Nicolas-Martinez-C/proto-synth-v2/docs/Pinout ProtoSynth V2.pdf

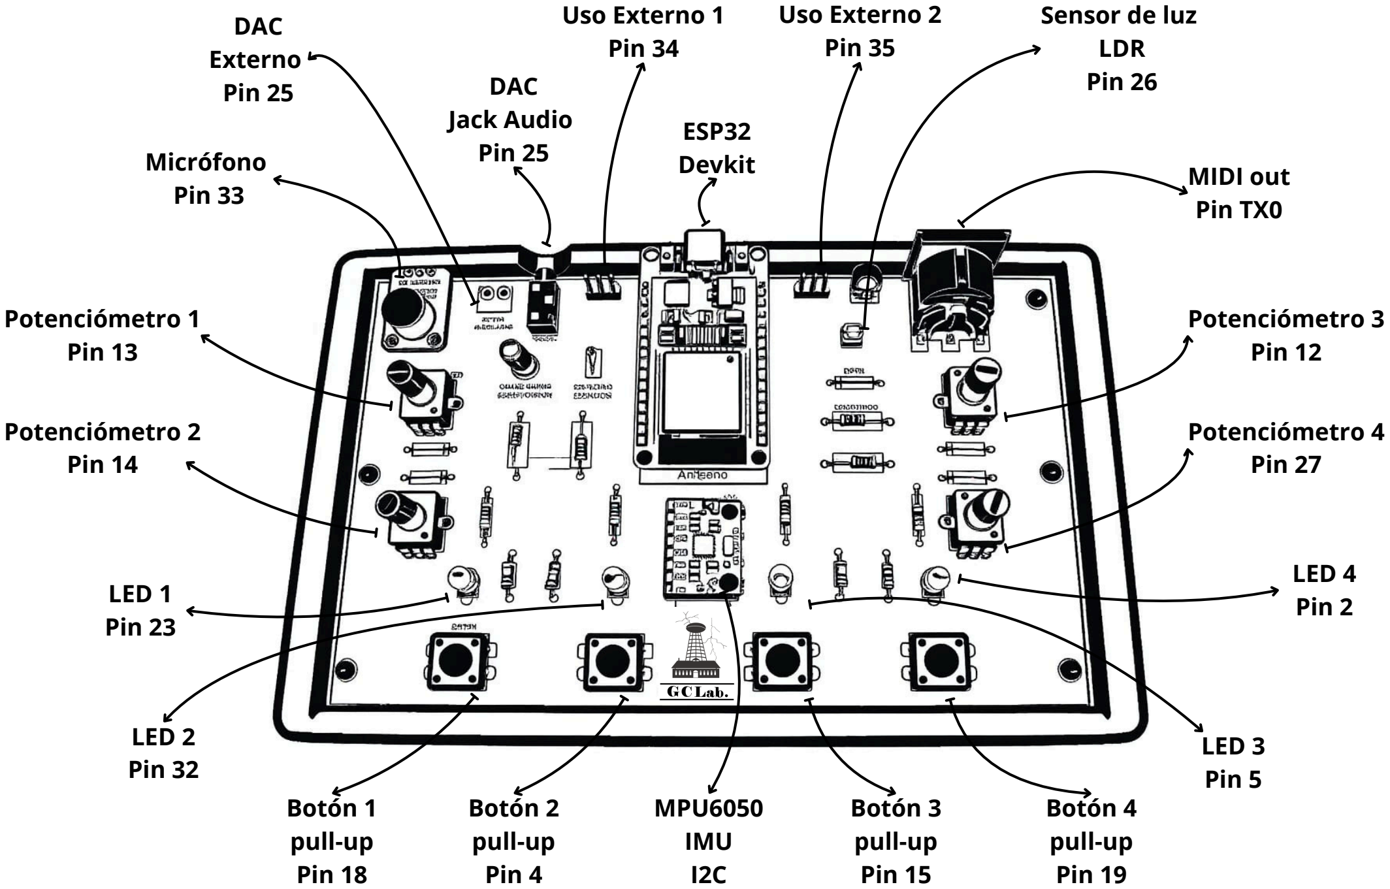
[picture p2: page 1]

Micrófono
Pin 33

Potenciómetro 1
Pin 13

Potenciómetro 2
Pin 14

DAC
Jack Audio
Pin 25

Potenciómetro 3
Pin 12

Potenciómetro 4
Pin 27

Botón 4
pull-up
Pin 19

Botón 3
pull-up
Pin 15

Botón 2
pull-up
Pin 4

Botón 1
pull-up
Pin 18

MIDI out
Pin TX0

ESP32
Devkit

Uso Externo 2
Pin 35

Uso Externo 1
Pin 34

DAC
Externo
Pin 25

Sensor de luz
LDR
Pin 26

LED 1
Pin 23

LED 2
Pin 32

LED 3
Pin 5

LED 4
Pin 2

MPU6050
IMU
I2C

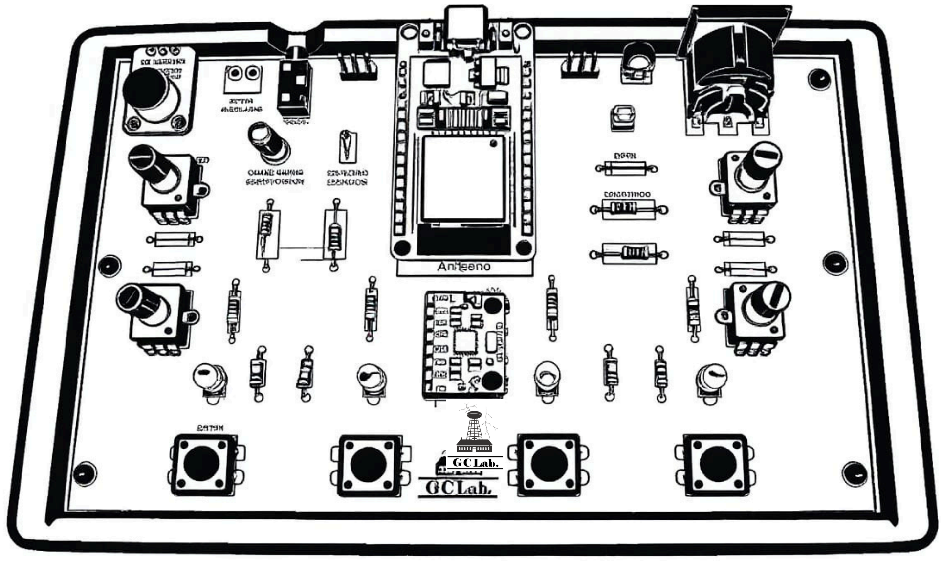
[picture p3: page 2]
