Nicolas-Martinez-C/proto-synth-v2/images/Conector de audifonos.png

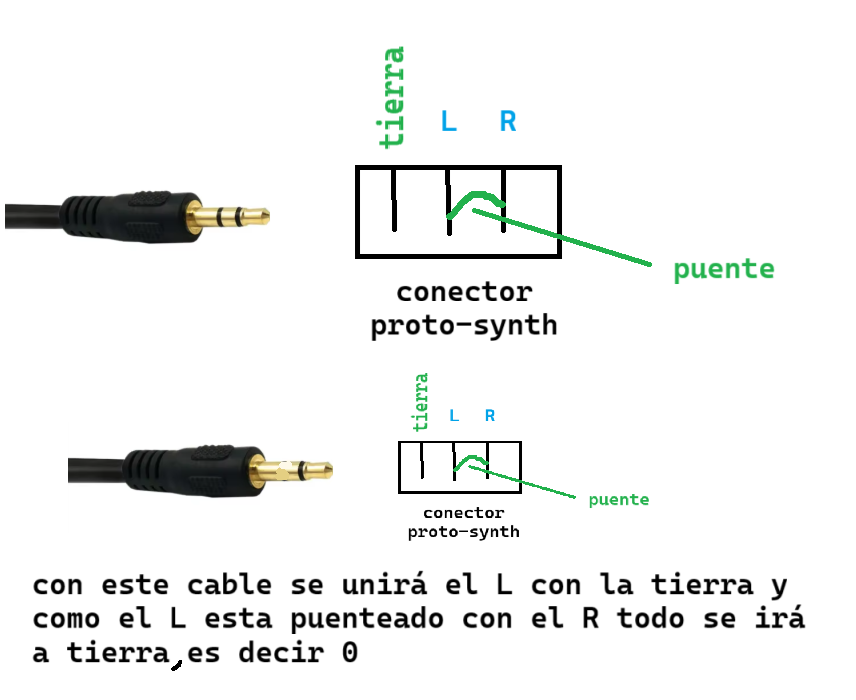
images/Conector de audifonos.png
