Nicolas-Martinez-C/proto-synth-v2/images/kit-Proto-synth.jpeg

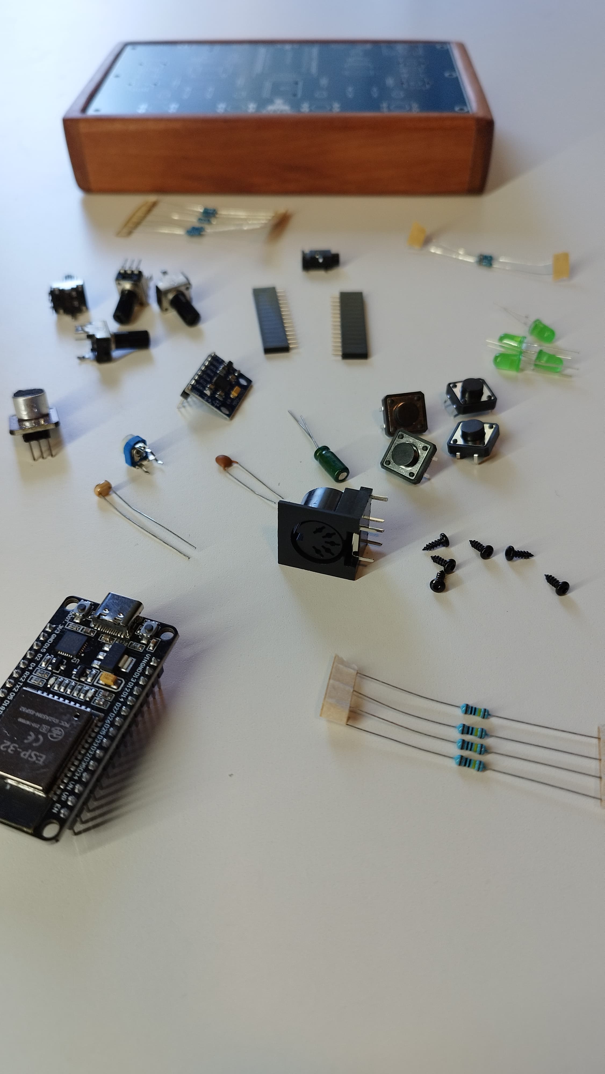
images/kit-Proto-synth.jpeg
