Nicolas-Martinez-C/proto-synth-v2/images/Proto-Synth-v1 y 2.jpeg

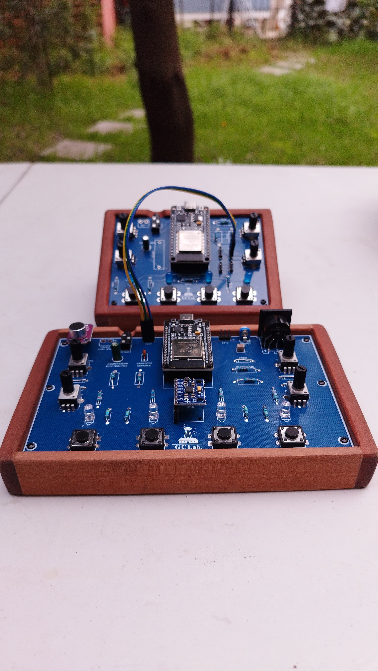
images/Proto-Synth-v1 y 2.jpeg
