Nicolas-Martinez-C/proto-synth-v2/images/Proto-synth-v2.0.0.jpeg

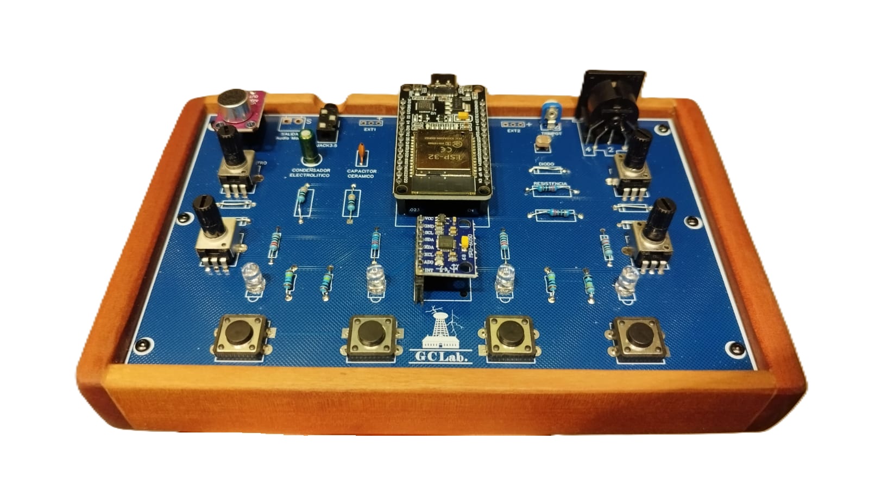
images/Proto-synth-v2.0.0.jpeg
