Nicolas-Martinez-C/proto-synth-v2/images/proto-synth-v2.jpg

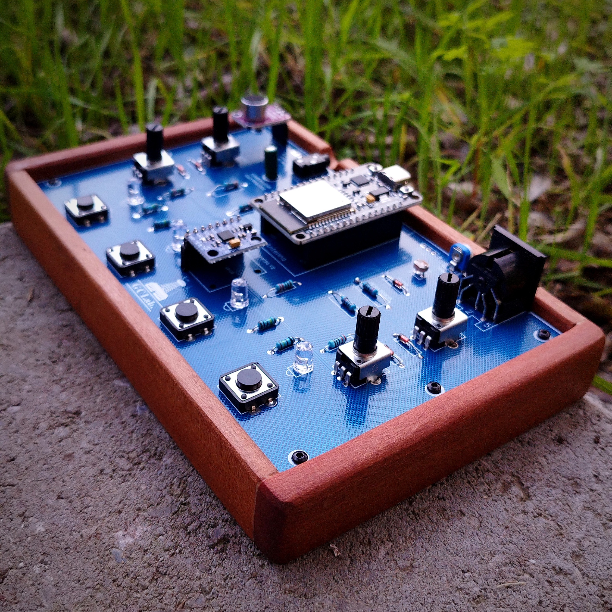
images/proto-synth-v2.jpg
