Nicolas-Martinez-C/proto-synth-v2/images/Proto_synth.png

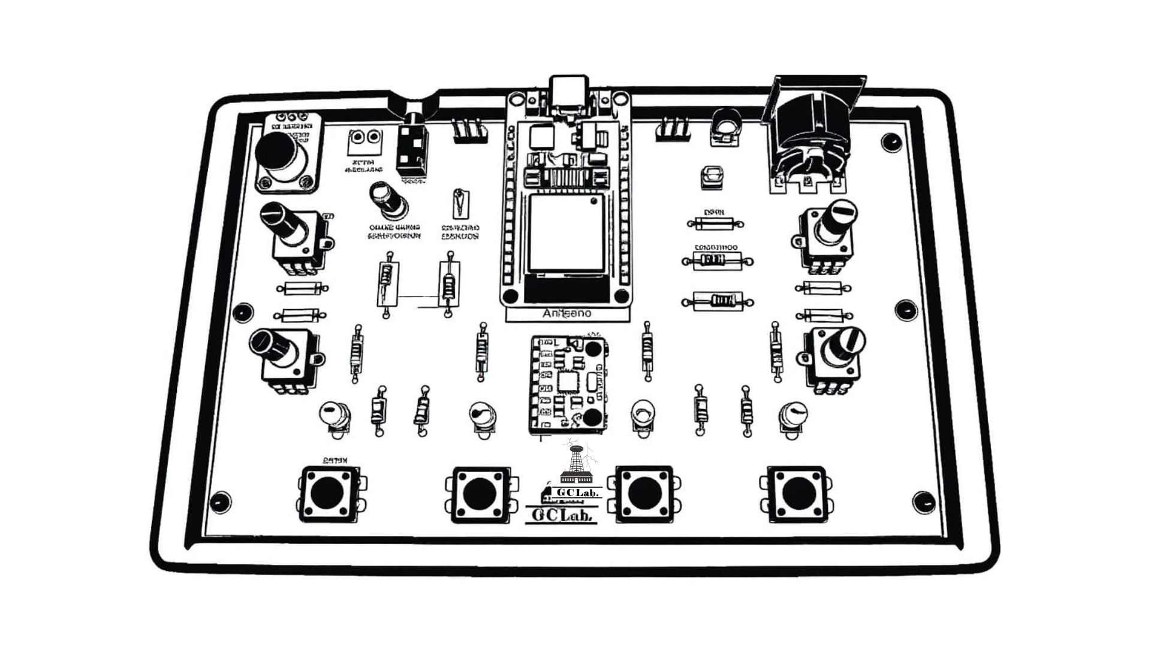
images/Proto_synth.png
