Nicolas-Martinez-C/proto-synth-v2/images/Schematic_Protosynth-V2.png

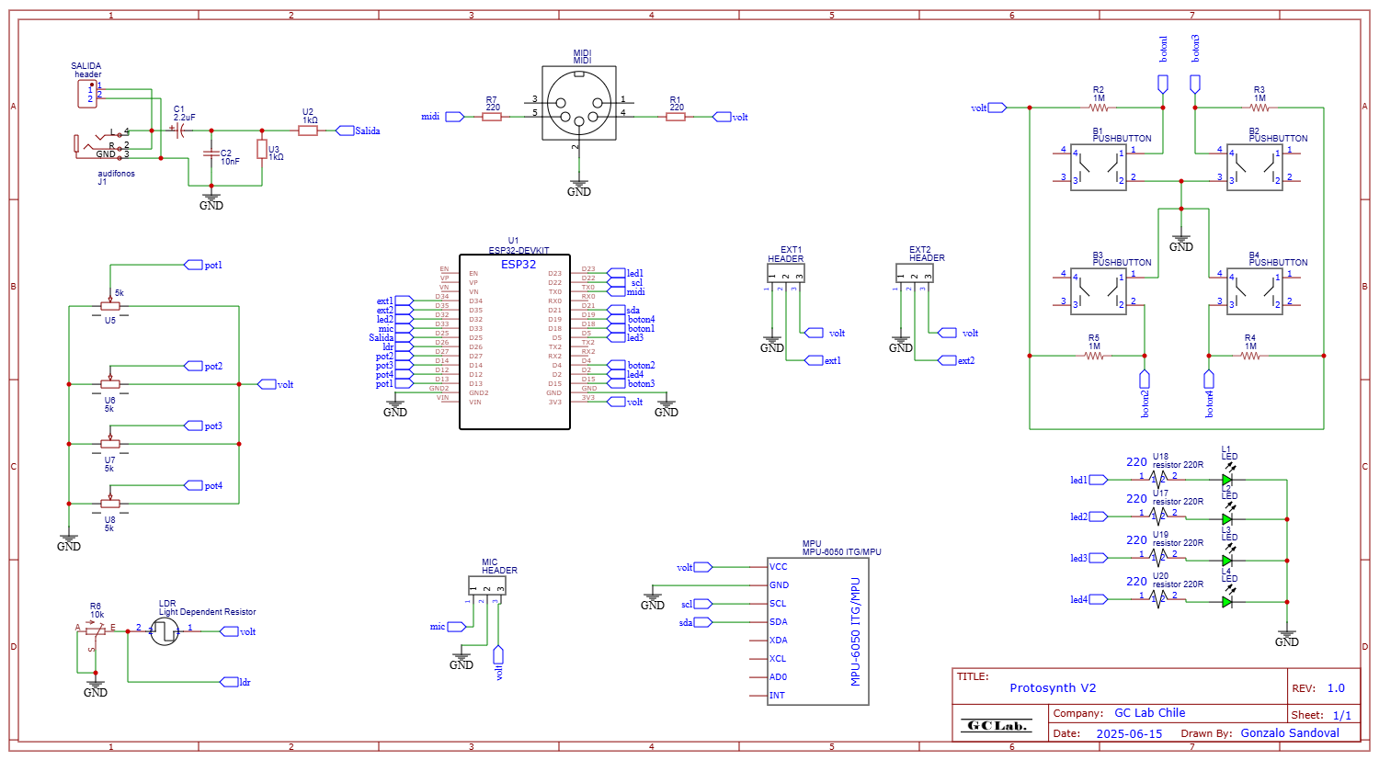
images/Schematic_Protosynth-V2.png
