Nicolas-Martinez-C/proto-synth-v2/hardware/PCB_protosynth-v2.pdf

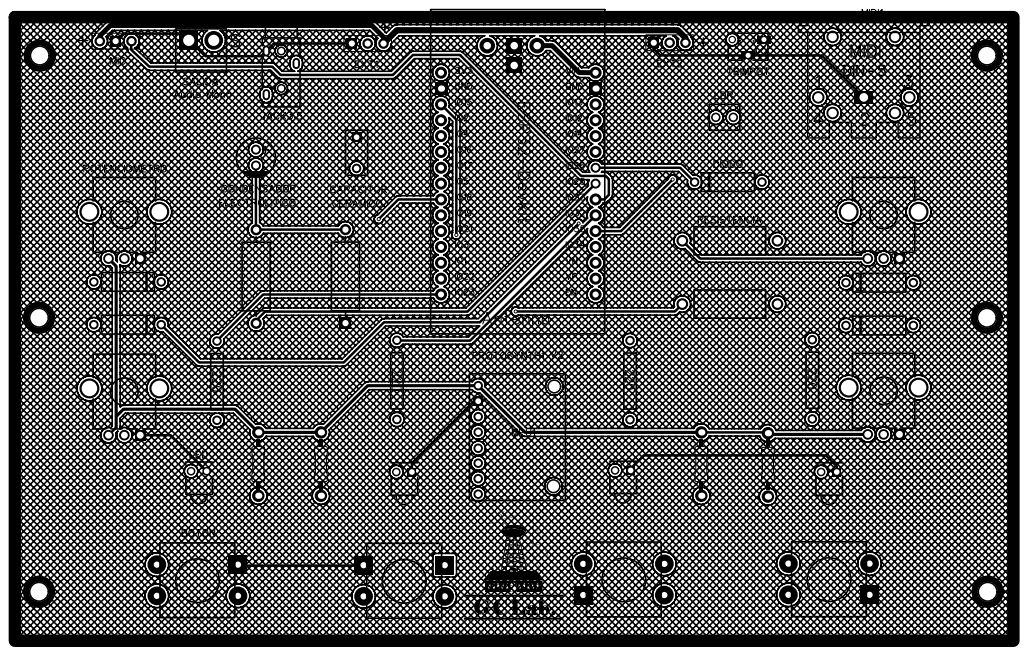
[picture p11: page 1]
