Nicolas-Martinez-C/proto-synth-v2/hardware/Schematic_Protosynth-V2.pdf

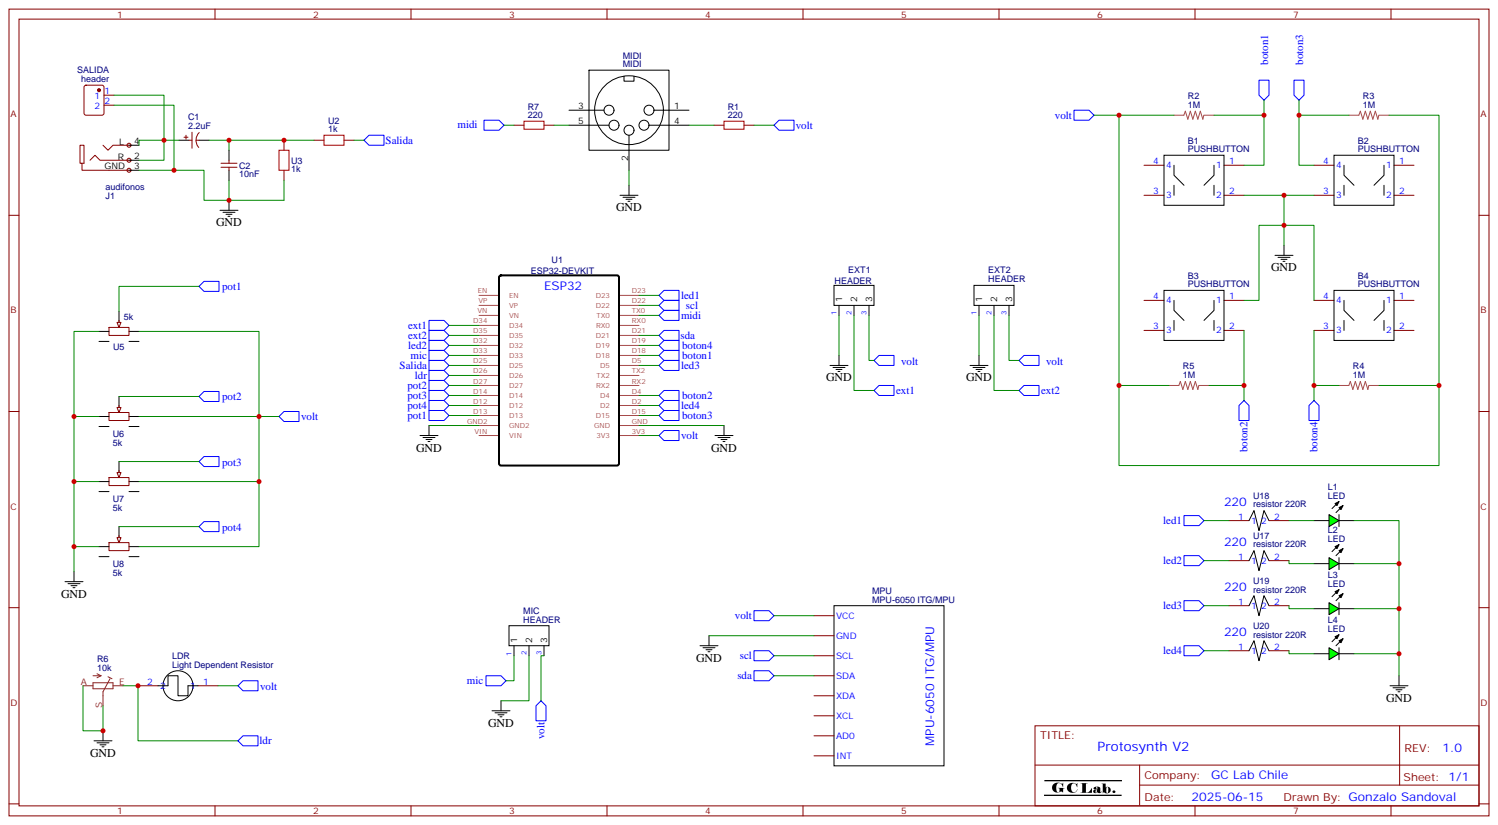
[picture p12: page 1]

Company: GC Lab Chile

Drawn By: Gonzalo Sandoval
