Nicolas-Martinez-C/proto-synth-v2/firmwares/idioteque_final/idioteque_final.ino

// ==============================================================================================================================================
// PROTO-SYNTH V2 - IDIOTEQUE SAMPLE (RADIOHEAD) - GC Lab Chile
// ==============================================================================================================================================

// ==============================================================================================================================================
// HARDWARE
// ==============================================================================================================================================
// - Microcontrolador ESP32 DevKit
// - Sensor de movimiento IMU MPU6050 (acelerómetro/giroscopio I2C) |VCC -> 3.3V, GND -> GND, SCL -> PIN 22, SDA -> PIN 21| 
// - 4 Botones con pull-up |1 -> PIN 18, 2 -> PIN 4, 3 -> PIN 15, 4 -> PIN 19|
// - 4 LEDs indicadores |1 -> PIN 23, 2 -> PIN 32, 3 -> PIN 5, 4 -> PIN 2|
// - 4 Potenciómetros analógicos |1 -> PIN 13, 2 -> PIN 14, 3 -> PIN 12, 4 -> PIN 27|
// - Salida MIDI (Serial Hardware, 31250 baudio) |Pin TX0| 
// - Sensor de luz LDR |Pin 26|
// - Jack de audio DAC |Pin 25|
// - Micrófono |Pin 33|
// - 2 Headers para conexiones adicionales |1 -> PIN 34, 2 -> PIN 35|
// ==============================================================================================================================================

// ==============================================================================================================================================
// DESCRIPCIÓN
// ==============================================================================================================================================
// Sampler simple de 4 samples basado en el tema "Idioteque" de Radiohead.
// ==============================================================================================================================================

// ==============================================================================================================================================
// FUNCIONAMIENTO
// ==============================================================================================================================================
// CONTROLES DE EXPRESIÓN:
// - Potenciómetro 1: Pitch (0.5x - 2.0x velocidad)
// - Potenciómetro 2: No se usa
// - Potenciómetro 3: No se usa
// - Potenciómetro 4: No se usa
// - Botón 1: Lanza Sample 1
// - Botón 2: Lanza Sample 2
// - Botón 3: Lanza Sample 3
// - Botón 4: Lanza Sample 4
// - LED 1: Sample 1 Activo
// - LED 2: Sample 2 Activo
// - LED 3: Sample 3 Activo
// - LED 4: Sample 4 Activo
// - IMU: No se usa
// - LDR: No se usa
// - Header 1: No se usa
// - Header 2: No se usa
// - Salida MIDI: No se usa
//
// MODO DE USO:
// 1. Presiona cualquier botón para reproducir, detener o cambiar el sample que está sonando, solo un sample 
//    puede reproducirse a la vez, los LEDs indican el sample activo.
// 2. Puedes cambiar el pitch ysando el potenciometro 1.
//
// INFORMACIÓN DEL CODIGO:
// - Reemplaza los datos de sample2Data, sample3Data y sample4Data con los arrays completos de tus samples 2, 3 y 4.
// - Mantén el formato PROGMEM para ahorrar RAM.
// - Los samples se detienen automáticamente al terminar.
// - El debounce evita múltiples activaciones accidentales.
// ==============================================================================================================================================

// ==============================================================================================================================================
// COMENTARIOS
// ==============================================================================================================================================
// - Falta control de volumen.
// - Hay 2 potenciometros aún disponibles para agregar mas controles de síntesis o efectos.
// - No copies y pegues este codigo en un LLM, es muy grande, si lo haces procura hacer una copia de los samples y luego 
//   pasarle al LLM solo la logica sin los samples. 
// - Para subir código exitosamente, asegúrate de que el Potenciómetro 3 esté girado al máximo.
// - Los Pines 2,4,12,13,14,15,25,26,27 no van a funcionar si el Bluetooth está activado ya que están conectados al ADC2 del ESP32.
// ==============================================================================================================================================

// ==============================================================================================================================================
// INCLUSIÓN DE LIBRERÍAS
// ==============================================================================================================================================
#include <driver/dac.h>
#include <Arduino.h>

// ==============================================================================================================================================
// CONFIGURACIÓN DE HARDWARE - PINES
// ==============================================================================================================================================
const int BUTTON_1 = 18;    // Botón 1 pull-up
const int BUTTON_2 = 4;     // Botón 2 pull-up  
const int BUTTON_3 = 15;    // Botón 3 pull-up
const int BUTTON_4 = 19;    // Botón 4 pull-up
const int PITCH_POT = 13;   // Potenciómetro 1
const int LED_1 = 23;       // LED 1
const int LED_2 = 32;       // LED 2
const int LED_3 = 5;        // LED 3
const int LED_4 = 2;        // LED 4
// DAC automático en PIN 25

// ==============================================================================================================================================
// PROGRAMA
// ==============================================================================================================================================
// ===== SAMPLES DATA =====
const int sampleRate = 11025;
// Sample 1 - Aquí debes poner los datos de tu sample1
const int sample1Length = 17572;
const uint16_t sample1Data[] PROGMEM = {
  2047,2043,2039,2037,2039,2036,2034,2034,2031,2033,2049,2065,2082,2102,2097,2078,
  2081,2076,2041,2022,2021,1987,1952,1965,1985,2018,2081,2109,2070,2030,2008,1979,
  2021,2133,2168,2118,2102,2082,1972,1919,1982,1982,1939,1976,2004,1983,2056,2161,
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
  dac_output_voltage(DAC_CHANNEL_1, 128);
  
  // Test LEDs
  Serial.println("ESP32 4-Button Sampler iniciado");
  for (int i = 0; i < 4; i++) {
    digitalWrite(players[i].ledPin, HIGH);
    delay(200);
    digitalWrite(players[i].ledPin, LOW);
    delay(200);
  }
}

void startSample(int sampleIndex) {
  // Detener cualquier sample que esté reproduciéndose
  stopAllSamples();
  
  // Iniciar el nuevo sample
  players[sampleIndex].isPlaying = true;
  players[sampleIndex].position = 0.0;
  currentlyPlaying = sampleIndex;
  nextSampleTime = micros();
  digitalWrite(players[sampleIndex].ledPin, HIGH);
  
  Serial.print("Reproduciendo Sample ");
  Serial.println(sampleIndex + 1);
}

void stopAllSamples() {
  for (int i = 0; i < 4; i++) {
    players[i].isPlaying = false;
    digitalWrite(players[i].ledPin, LOW);
  }
  currentlyPlaying = -1;
  dac_output_voltage(DAC_CHANNEL_1, 128);
}

void processAudio() {
  if (currentlyPlaying < 0) return;
  
  unsigned long currentTime = micros();
  
  if (currentTime >= nextSampleTime) {
    SamplePlayer* player = &players[currentlyPlaying];
    
    // Leer potenciómetro para pitch
    int pitchPot = analogRead(PITCH_POT);
    pitchMultiplier = map(pitchPot, 0, 4095, 50, 200) / 100.0;
    
    int currentIndex = (int)player->position;
    
    if (currentIndex < player->length) {
      // Leer sample de la memoria PROGMEM
      uint16_t sample12bit = pgm_read_word(&player->data[currentIndex]);
      
      // Interpolación lineal para mejor calidad
      if (currentIndex < player->length - 1) {
        uint16_t nextSample = pgm_read_word(&player->data[currentIndex + 1]);
        float fraction = player->position - currentIndex;
        sample12bit = sample12bit + (uint16_t)(fraction * (nextSample - sample12bit));
      }
      
      // Convertir a 8-bit para el DAC
      uint8_t sample8bit = sample12bit >> 4;
      dac_output_voltage(DAC_CHANNEL_1, sample8bit);
      
      // Avanzar posición según el pitch
      player->position += pitchMultiplier;
      
      // Calcular tiempo del próximo sample
      float samplePeriod = (1000000.0 / sampleRate) / pitchMultiplier;
      nextSampleTime = currentTime + (unsigned long)samplePeriod;
      
    } else {
      // Sample terminado
      stopAllSamples();
      Serial.print("Sample ");
      Serial.print(currentlyPlaying + 1);
      Serial.println(" terminado");
    }
  }
}

void handleButtons() {
  for (int i = 0; i < 4; i++) {
    bool currentButtonState = digitalRead(buttons[i]);
    
    // Detectar flanco descendente (botón presionado)
    if (lastButtonStates[i] == HIGH && currentButtonState == LOW) {
      if (millis() - lastButtonTimes[i] > 50) { // Debounce
        if (players[i].isPlaying) {
          // Si el sample está reproduciéndose, detenerlo
          stopAllSamples();
          Serial.print("Detenido Sample ");
          Serial.println(i + 1);
        } else {
          // Si no se está reproduciendo, iniciarlo
          startSample(i);
        }
        lastButtonTimes[i] = millis();
      }
    }
    
    lastButtonStates[i] = currentButtonState;
  }
}

void loop() {
  handleButtons();
  processAudio();
  delayMicroseconds(10);
}
